jaytektas/feeder/Pogo.webp

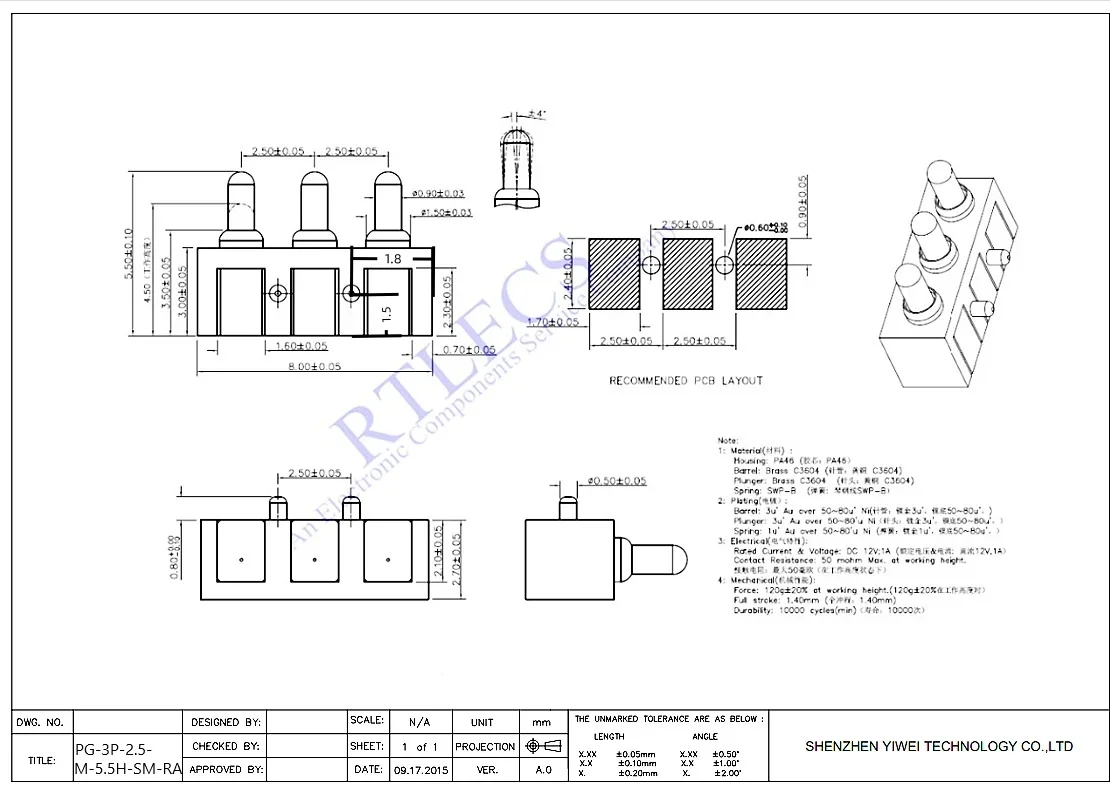
Pogo.webp
