jaytektas/feeder/3D models/pogo v1.step

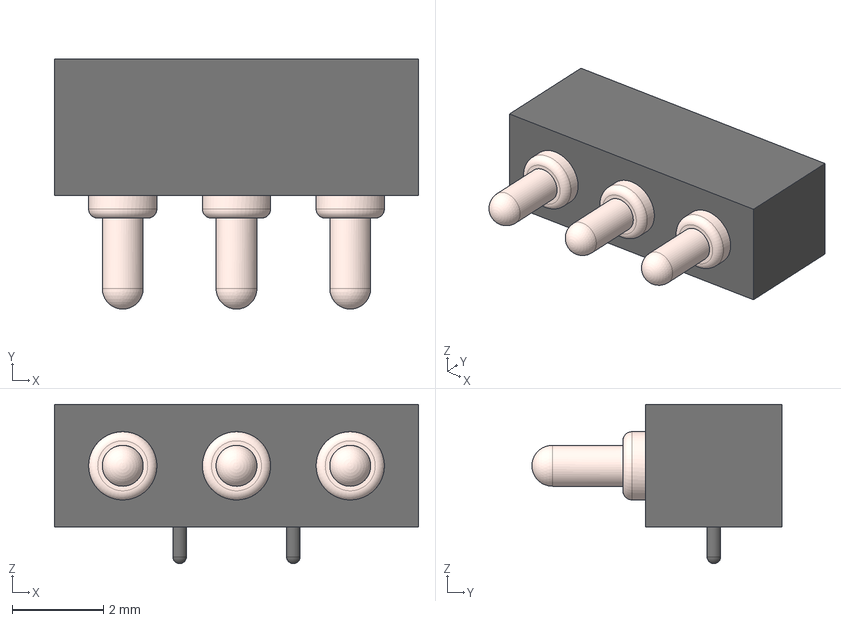
[picture p2: CAD file, 2025-06-05]
3D models/pogo v1.step
8.00 x 5.50 x 3.50 mm
