jaytektas/feeder/3D models/1TS003B-1400-3500A-CT.step

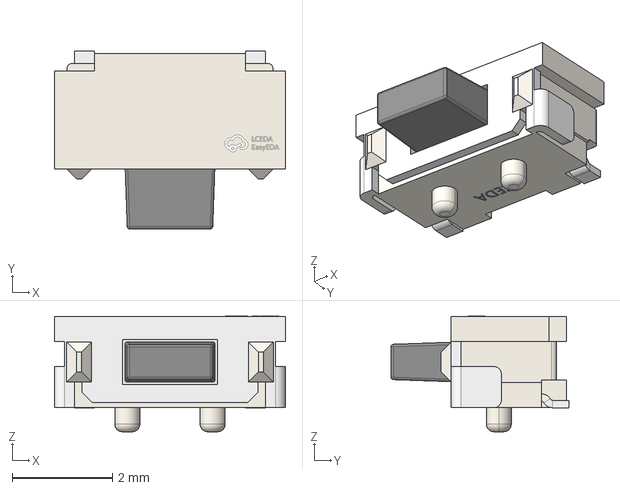
[picture p3: CAD file, 2025-06-05]
3D models/1TS003B-1400-3500A-CT.step
4.60 x 3.55 x 2.30 mm
