jaytektas/feeder/3D models/Inductor_63.step

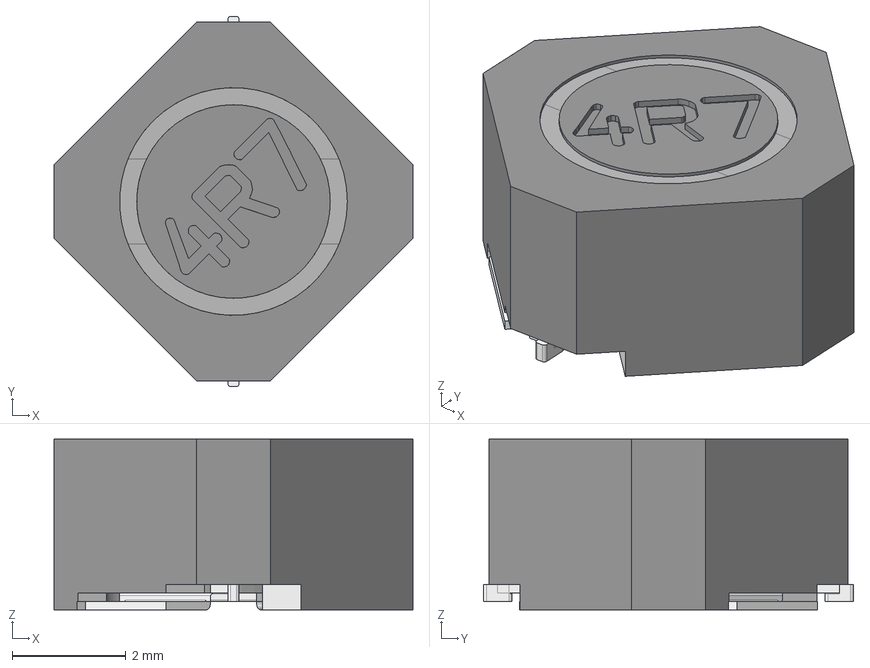
[picture p4: CAD file, 2025-06-05]
3D models/Inductor_63.step
6.30 x 6.50 x 3.00 mm
Protection
Inner_Pins
Inductor_Core
Pins
Inductor_Case
