jaytektas/feeder/(list of files, cad)

Other CAD files:
1TS003B-1400-3500A-CT.3mf
