jaytektas/feeder/feeder.kicad_pcb

## KiCad design feeder.kicad_pcb (2025-06-22)

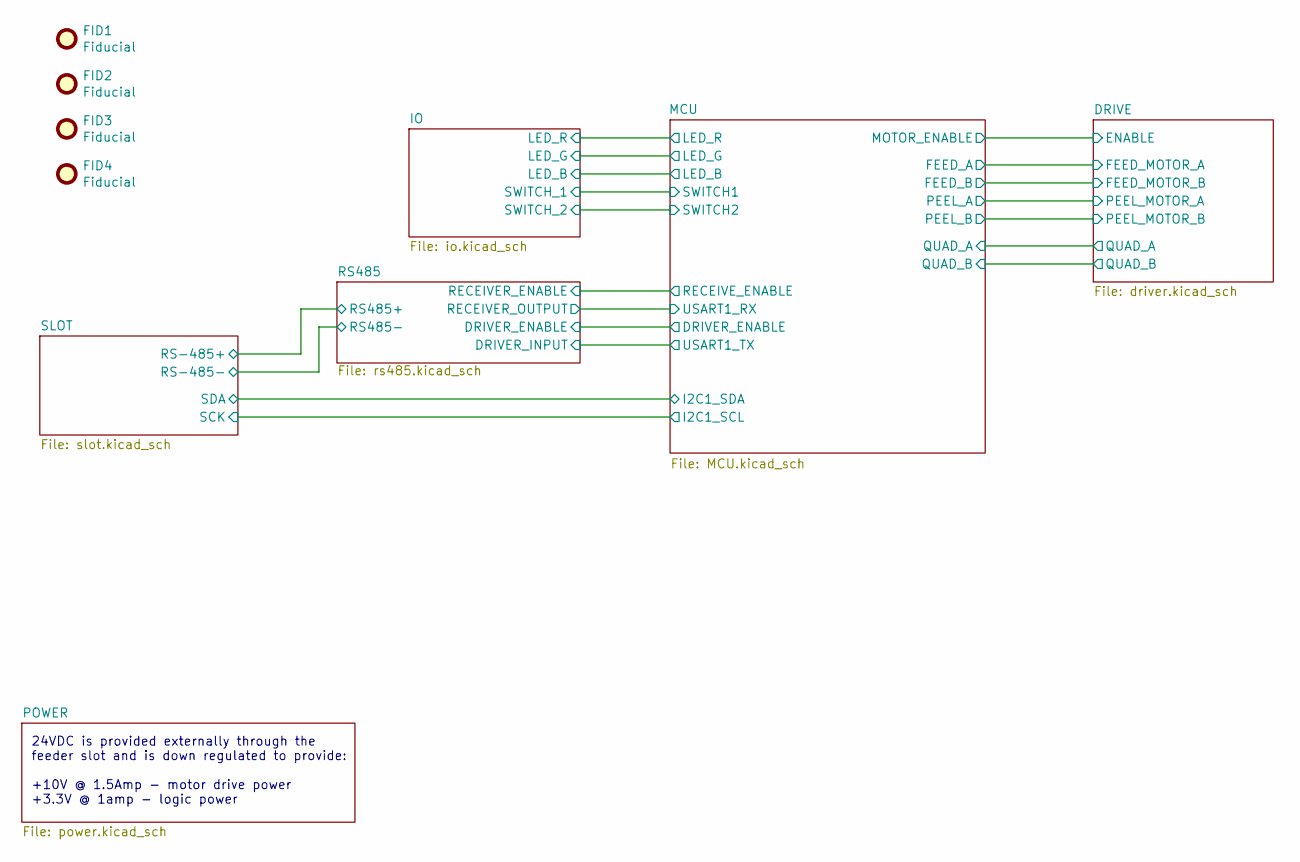
[picture p5: schematic feeder.kicad_sch]

Parts:
FID1, FID2, FID3, FID4: Fiducial; Fiducial_1mm_Mask2mm

Notes on the sheet:
24VDC is provided externally through the feeder slot and is down regulated to provide: +10V @ 1.5Amp - motor drive power +3.3V @ 1amp - logic power

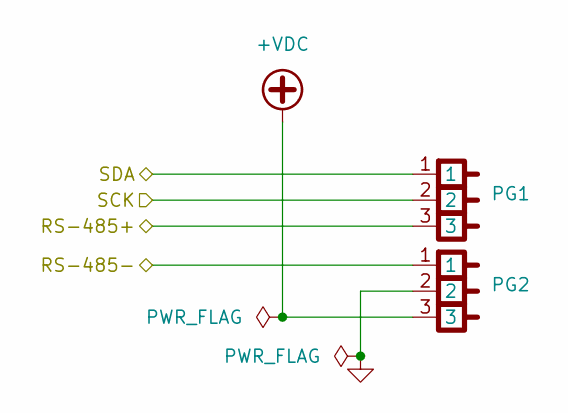
[picture p6: schematic slot.kicad_sch]

Parts:
PG1, PG2: POGO_3

Connections:
+VDC: PG2.3; also elsewhere on the board
/MCU/I2C1_SCL: PG1.2; also elsewhere on the board
/MCU/I2C1_SDA: PG1.1; also elsewhere on the board
/RS485/RS485+: PG1.3; also elsewhere on the board
/RS485/RS485-: PG2.1; also elsewhere on the board
GND: PG2.2; also elsewhere on the board

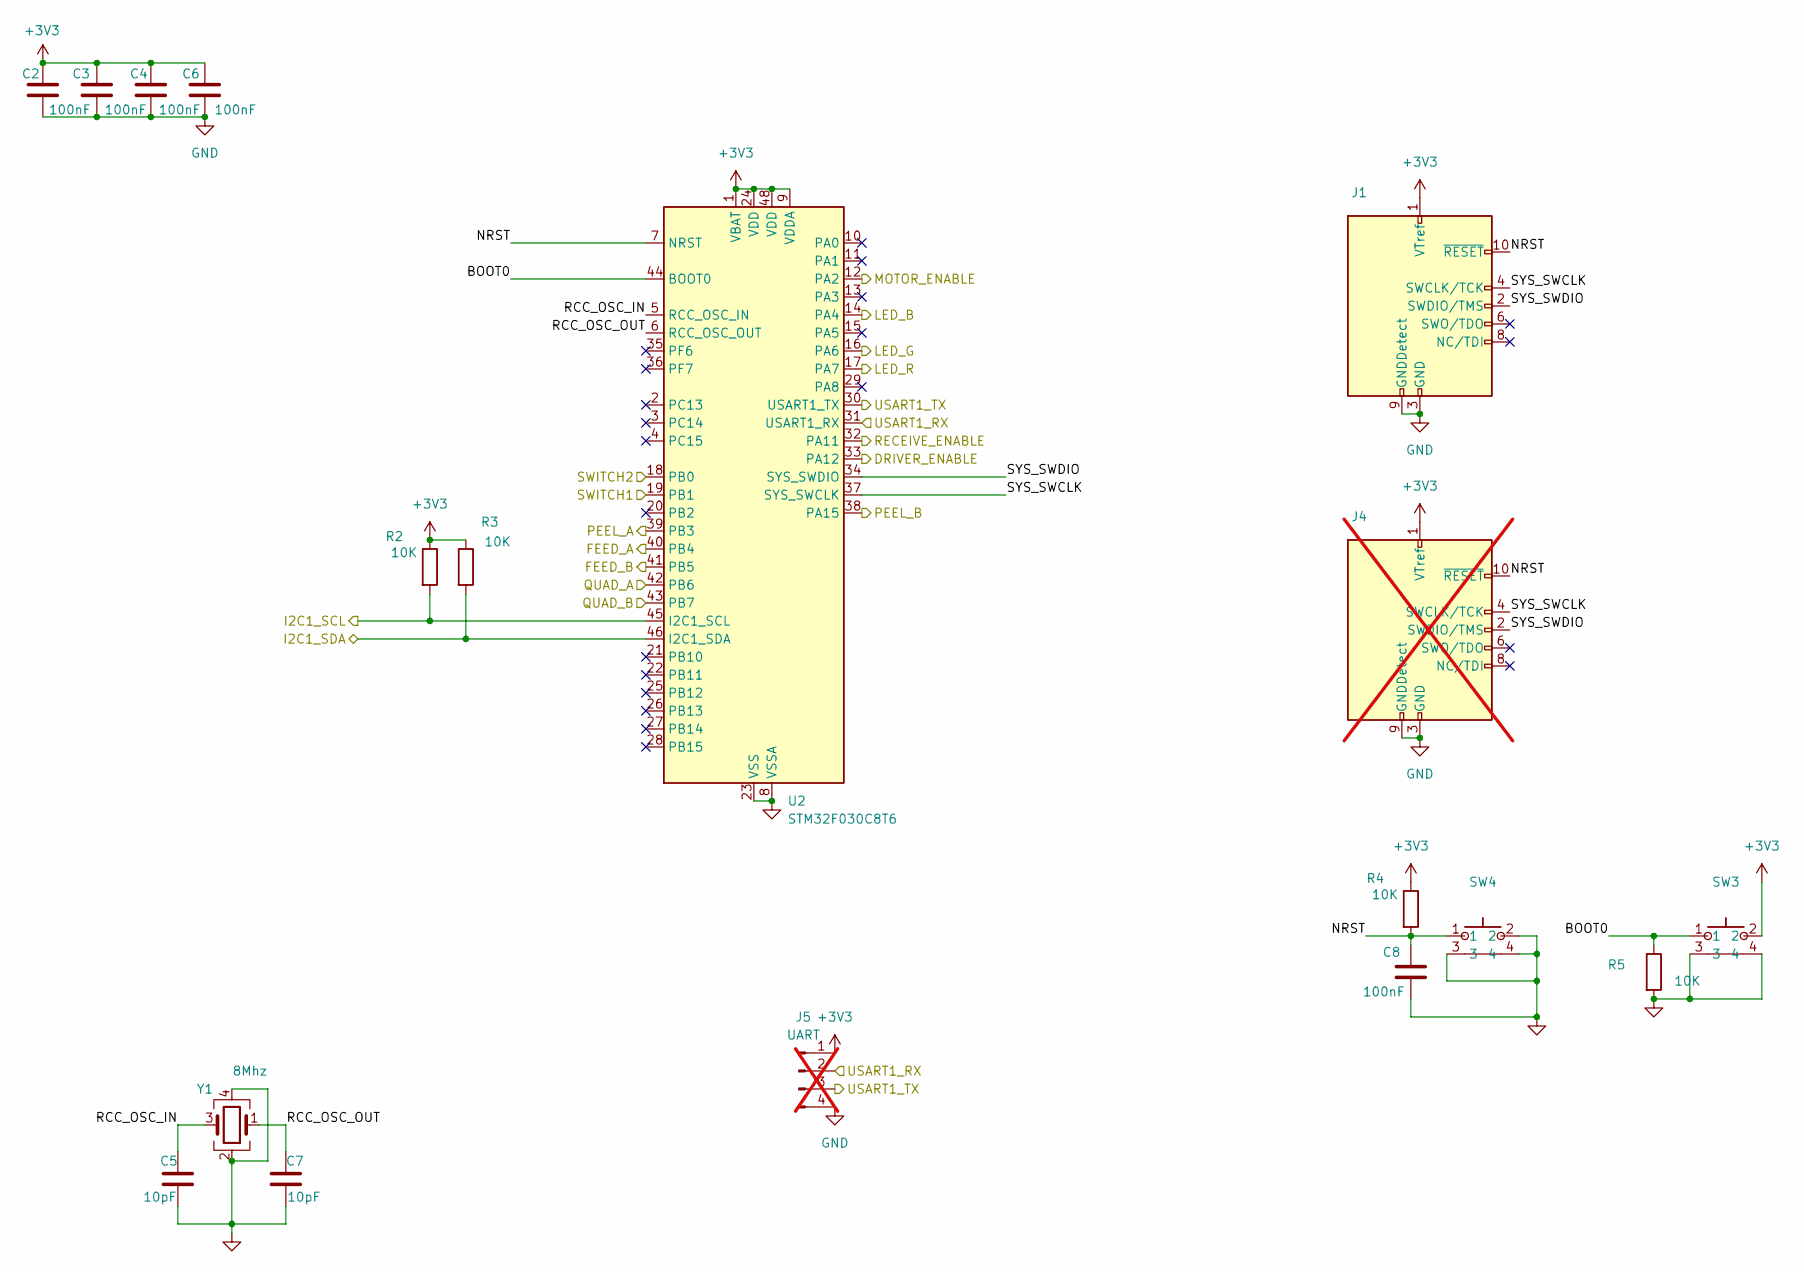
[picture p7: schematic MCU.kicad_sch]

Parts:
C2, C3, C4, C6, C8: 100nF; C_0603_1608Metric; LCSC C14663
C5, C7: 10pF; C_0603_1608Metric; LCSC C1634
J1: Conn_ARM_JTAG_SWD_10; PinHeader_2x05_P1.27mm_Vertical_SMD; LCSC C6332249
J4: Conn_ARM_JTAG_SWD_10; PinHeader_2x05_P1.27mm_Vertical_SMD; LCSC C6332249; not fitted
J5: UART; PinHeader_1x04_P2.54mm_Vertical; LCSC C2691448; not fitted
R2, R3, R4, R5: 10K; R_0603_1608Metric; LCSC C25804
SW3, SW4: 1TS003B-1400-3500A-CT; LCSC C319392
U2: STM32F030C8T6; LQFP-48_7x7mm_P0.5mm; LCSC C23922
Y1: 8Mhz; Crystal_SMD_3225-4Pin_3.2x2.5mm; LCSC C648984

Connections:
+3V3: C2.1, C3.1, C4.1, C6.1, J1.1 (VTref), J4.1 (VTref), J5.1, R2.1, R3.1, R4.1, SW3.2, U2.1 (VBAT), U2.9 (VDDA), U2.24 (VDD), U2.48 (VDD); also elsewhere on the board
/DRIVE/ENABLE: U2.12 (PA2); also elsewhere on the board
/DRIVE/FEED_MOTOR_A: U2.40 (PB4); also elsewhere on the board
/DRIVE/FEED_MOTOR_B: U2.41 (PB5); also elsewhere on the board
/DRIVE/PEEL_MOTOR_A: U2.39 (PB3); also elsewhere on the board
/DRIVE/PEEL_MOTOR_B: U2.38 (PA15); also elsewhere on the board
/DRIVE/QUAD_A: U2.42 (PB6); also elsewhere on the board
/DRIVE/QUAD_B: U2.43 (PB7); also elsewhere on the board
/IO/LED_B: U2.14 (PA4); also elsewhere on the board
/IO/LED_G: U2.16 (PA6); also elsewhere on the board
/IO/LED_R: U2.17 (PA7); also elsewhere on the board
/IO/SWITCH_1: U2.19 (PB1); also elsewhere on the board
/IO/SWITCH_2: U2.18 (PB0); also elsewhere on the board
/MCU/BOOT0: R5.1, SW3.1, U2.44 (BOOT0)
/MCU/DRIVER_ENABLE: U2.33 (PA12); also elsewhere on the board
/MCU/I2C1_SCL: R2.2, U2.45 (I2C1_SCL); also elsewhere on the board
/MCU/I2C1_SDA: R3.2, U2.46 (I2C1_SDA); also elsewhere on the board
/MCU/NRST: C8.1, J1.10 (~RESET), J4.10 (~RESET), R4.2, SW4.1, U2.7 (NRST)
/MCU/RCC_OSC_IN: C5.2, U2.5 (RCC_OSC_IN), Y1.3
/MCU/RCC_OSC_OUT: C7.2, U2.6 (RCC_OSC_OUT), Y1.1
/MCU/RECEIVE_ENABLE: U2.32 (PA11); also elsewhere on the board
/MCU/SYS_SWCLK: J1.4 (SWCLK/TCK), J4.4 (SWCLK/TCK), U2.37 (SYS_SWCLK)
/MCU/SYS_SWDIO: J1.2 (SWDIO/TMS), J4.2 (SWDIO/TMS), U2.34 (SYS_SWDIO)
/MCU/USART1_RX: J5.2, U2.31 (USART1_RX); also elsewhere on the board
/MCU/USART1_TX: J5.3, U2.30 (USART1_TX); also elsewhere on the board
GND: C2.2, C3.2, C4.2, C5.1, C6.2, C7.1, C8.2, J1.3 (GND), J1.5 (GND), J1.9 (GNDDetect), J4.3 (GND), J4.5 (GND), J4.9 (GNDDetect), J5.4, R5.2, SW3.3, SW3.4, SW4.2, SW4.3, SW4.4, U2.8 (VSSA), U2.23 (VSS), U2.47 (VSS), Y1.2, Y1.4; also elsewhere on the board

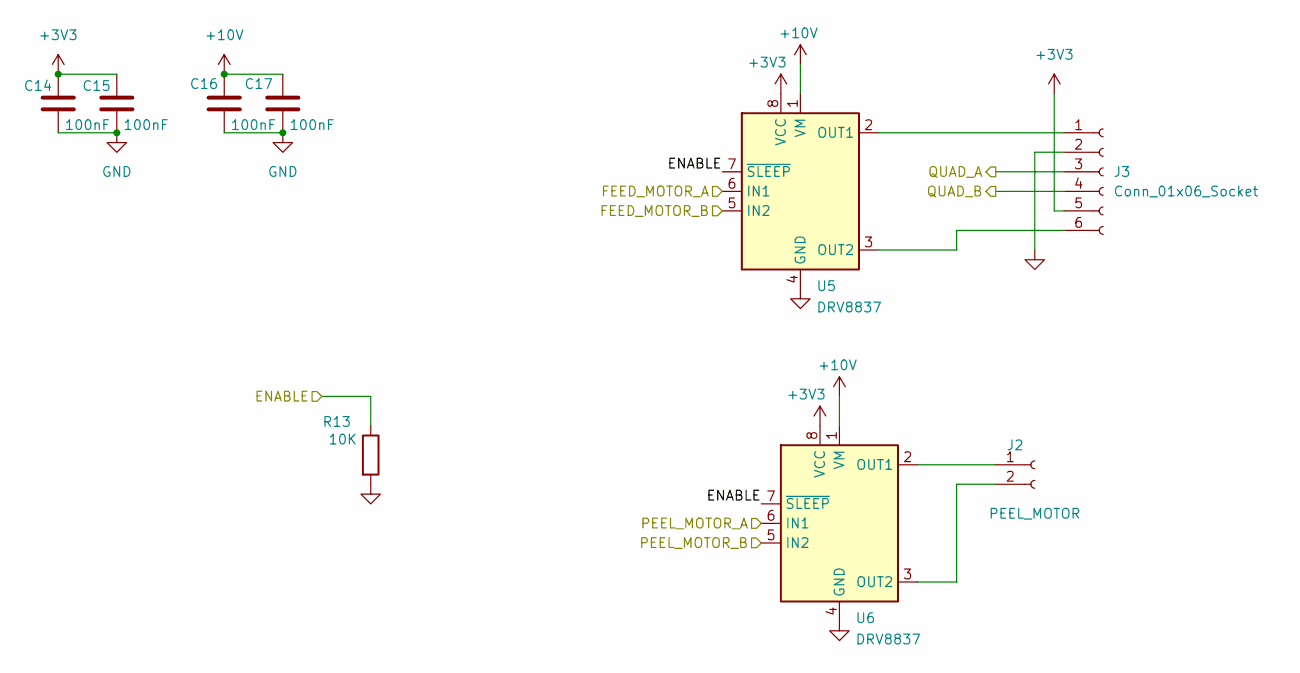
[picture p8: schematic driver.kicad_sch]

Parts:
C14, C15, C16, C17: 100nF; C_0603_1608Metric; LCSC C14663
J2: PEEL_MOTOR; Molex_PicoBlade_53261-0271_1x02-1MP_P1.25mm_Horizontal; LCSC C2845379
J3: Conn_01x06_Socket; Molex_PicoBlade_53261-0671_1x06-1MP_P1.25mm_Horizontal; LCSC C2845383
R13: 10K; R_0603_1608Metric; LCSC C25804
U5, U6: DRV8837; WSON-8-1EP_2x2mm_P0.5mm_EP0.9x1.6mm; LCSC C191000

Connections:
+3V3: C14.1, C15.1, J3.5, U5.8 (VCC), U6.8 (VCC); also elsewhere on the board
+10V: C16.1, C17.1, U5.1 (VM), U6.1 (VM); also elsewhere on the board
/DRIVE/ENABLE: R13.1, U5.7 (~SLEEP), U6.7 (~SLEEP); also elsewhere on the board
/DRIVE/FEED_MOTOR_A: U5.6 (IN1); also elsewhere on the board
/DRIVE/FEED_MOTOR_B: U5.5 (IN2); also elsewhere on the board
/DRIVE/PEEL_MOTOR_A: U6.6 (IN1); also elsewhere on the board
/DRIVE/PEEL_MOTOR_B: U6.5 (IN2); also elsewhere on the board
/DRIVE/QUAD_A: J3.3; also elsewhere on the board
/DRIVE/QUAD_B: J3.4; also elsewhere on the board
GND: C14.2, C15.2, C16.2, C17.2, J3.2, R13.2, U5.4 (GND), U5.9 (GND), U6.4 (GND), U6.9 (GND); also elsewhere on the board
unnamed: J2.1, U6.2 (OUT1)
unnamed: J2.2, U6.3 (OUT2)
unnamed: J3.1, U5.2 (OUT1)
unnamed: J3.6, U5.3 (OUT2)

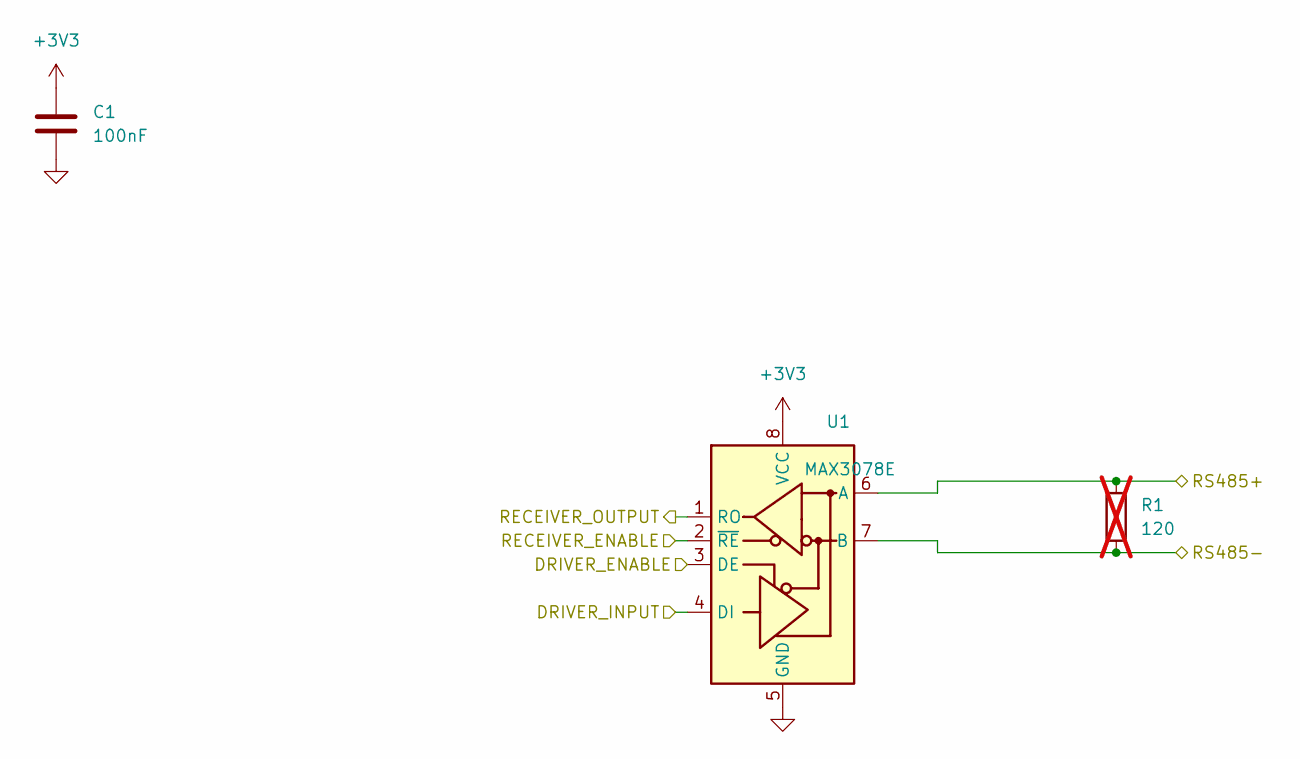
[picture p9: schematic rs485.kicad_sch]

Parts:
C1: 100nF; C_0603_1608Metric; LCSC C14663
R1: 120; R_0603_1608Metric; not fitted
U1: MAX3078E; SOIC-8_3.9x4.9mm_P1.27mm; LCSC C2885450

Connections:
+3V3: C1.1, U1.8 (VCC); also elsewhere on the board
/MCU/DRIVER_ENABLE: U1.3 (DE); also elsewhere on the board
/MCU/RECEIVE_ENABLE: U1.2 (~RE); also elsewhere on the board
/MCU/USART1_RX: U1.1 (RO); also elsewhere on the board
/MCU/USART1_TX: U1.4 (DI); also elsewhere on the board
/RS485/RS485+: R1.1, U1.6 (A); also elsewhere on the board
/RS485/RS485-: R1.2, U1.7 (B); also elsewhere on the board
GND: C1.2, U1.5 (GND); also elsewhere on the board

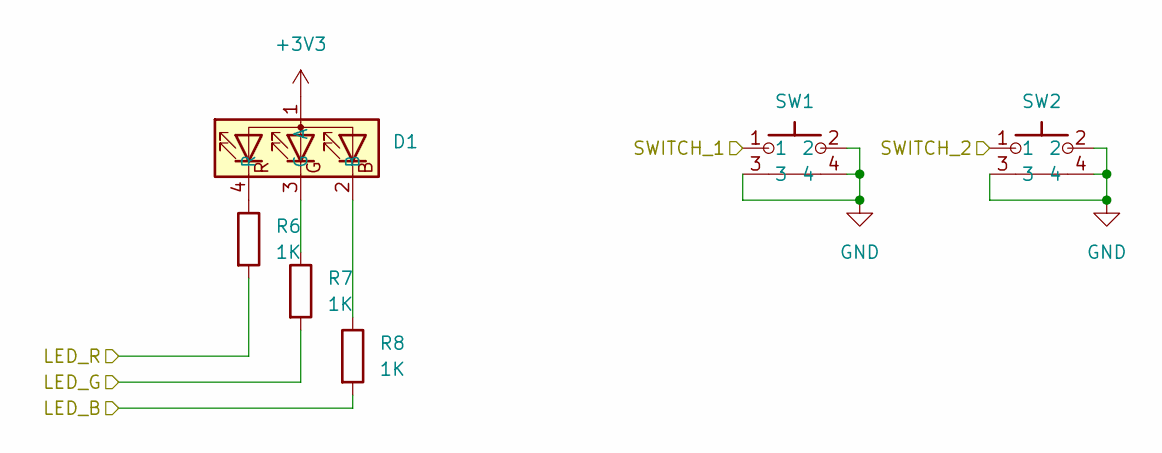
[picture p10: schematic io.kicad_sch]

Parts:
D1: MHS110FRGBCT; LCSC C496820
R6, R7, R8: 1K; R_0603_1608Metric; LCSC C21190
SW1, SW2: 1TS003B-1400-3500A-CT; LCSC C319392

Connections:
+3V3: D1.1 (A); also elsewhere on the board
/IO/LED_B: R8.2; also elsewhere on the board
/IO/LED_G: R7.2; also elsewhere on the board
/IO/LED_R: R6.2; also elsewhere on the board
/IO/SWITCH_1: SW1.1; also elsewhere on the board
/IO/SWITCH_2: SW2.1; also elsewhere on the board
GND: SW1.2, SW1.3, SW1.4, SW2.2, SW2.3, SW2.4; also elsewhere on the board
unnamed: D1.2 (B), R8.1
unnamed: D1.3 (G), R7.1
unnamed: D1.4 (R), R6.1

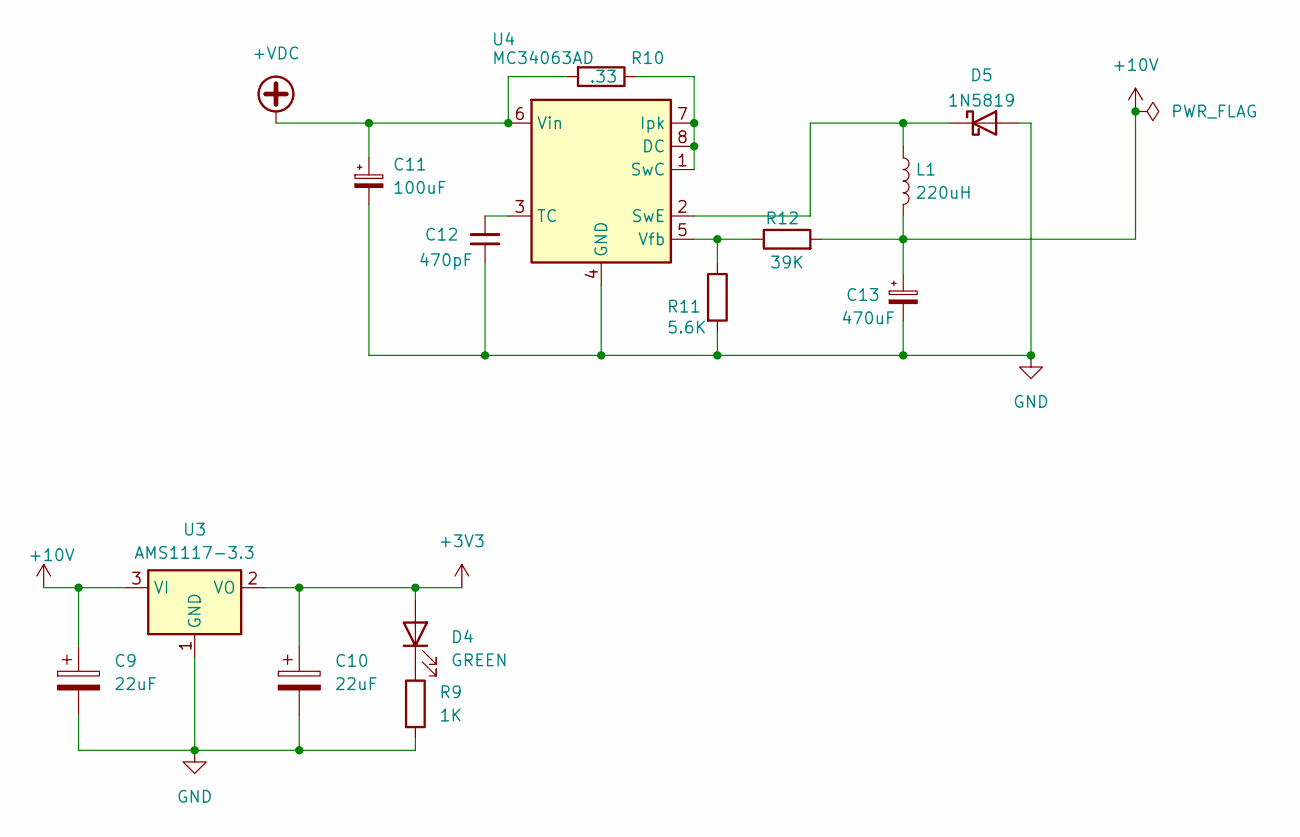
[picture p11: schematic power.kicad_sch]

Parts:
C9, C10: 22uF; C_1206_3216Metric; LCSC C7432785
C11: 100uF; C_Elec_6.3x7.7; LCSC C2836442
C12: 470pF; C_0603_1608Metric; LCSC C107092
C13: 470uF; C_Elec_6.3x7.7; LCSC C5354997
D4: GREEN; LED_0603_1608Metric; LCSC C965804
D5: 1N5819; D_SOD-123; LCSC C82544
L1: 220uH; SMNR6045; LCSC C467145
R9: 1K; R_0603_1608Metric; LCSC C21190
R10: .33; R_0805_2012Metric; LCSC C2934265
R11: 5.6K; R_0603_1608Metric; LCSC C114627
R12: 39K; R_0603_1608Metric; LCSC C163424
U3: AMS1117-3.3; SOT-223-3_TabPin2; LCSC C347222
U4: MC34063AD; SOIC-8_3.9x4.9mm_P1.27mm; LCSC C80213

Connections:
+3V3: C10.1, D4.2 (A), U3.2 (VO); also elsewhere on the board
+10V: C9.1, C13.1, L1.2, R12.2, U3.3 (VI); also elsewhere on the board
+VDC: C11.1, R10.2, U4.6 (Vin); also elsewhere on the board
GND: C9.2, C10.2, C11.2, C12.1, C13.2, D5.2 (A), R9.2, R11.2, U3.1 (GND), U4.4 (GND); also elsewhere on the board
unnamed: D4.1 (K), R9.1
unnamed: D5.1 (K), L1.1, U4.2 (SwE)
unnamed: R10.1, U4.1 (SwC), U4.7 (Ipk), U4.8 (DC)
unnamed: C12.2, U4.3 (TC)
unnamed: R11.1, R12.1, U4.5 (Vfb)

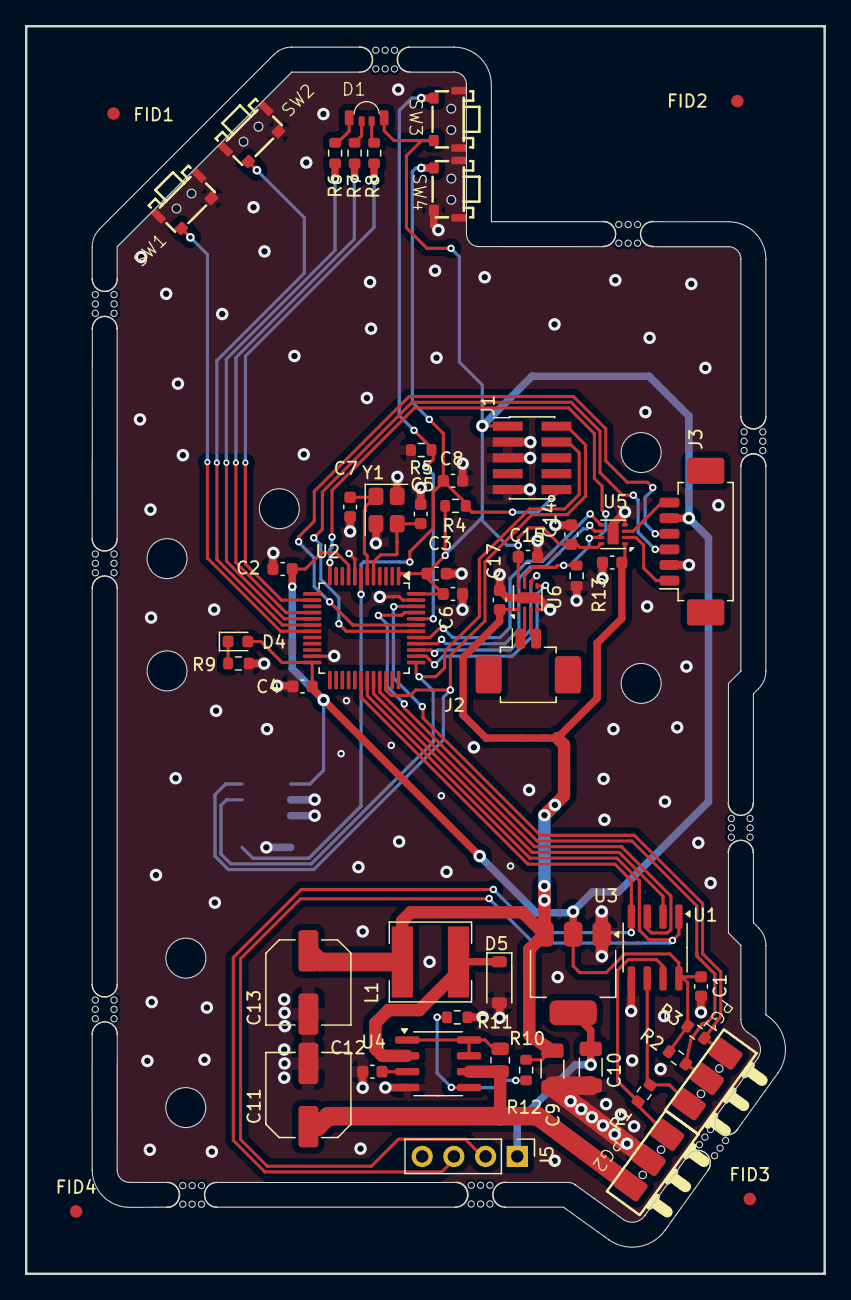
[picture p12: board feeder.kicad_pcb from above]

Board: 2 copper layers, 64.0 x 100.0 mm, 66 parts (1 on the bottom side), 42 nets.

Other parts of the board:
mouse-bite-2mm-slot, mouse-bite-2mm-slot#2, mouse-bite-2mm-slot#3, mouse-bite-2mm-slot#4, mouse-bite-2mm-slot#5, mouse-bite-2mm-slot#6, mouse-bite-2mm-slot#7, mouse-bite-2mm-slot#8, mouse-bite-2mm-slot#9, mouse-bite-2mm-slot#10: VAL**; mouse-bite-2mm-slot
