jaytektas/feeder/(commit log)

2025-06-05 feeder pcb files
    [1TS003B-1400-3500A-CT.3mf, 1TS003B-1400-3500A-CT.step, Inductor_63.step, MCU.kicad_sch, bom.csv, designators.csv, driver.kicad_sch, feeder.kicad_pcb]
2025-06-22 updated part sizes for pick and place
    [MCU.kicad_sch, driver.kicad_sch, feeder.kicad_pcb, io.kicad_sch, power.kicad_sch, rs485.kicad_sch, slot.kicad_sch]
2025-06-22 imported schematic fields to pcb for placement
    [feeder.kicad_pcb]
